FloatingComet62/phenotype-pi/references/ssr-40da-fotek.jpeg

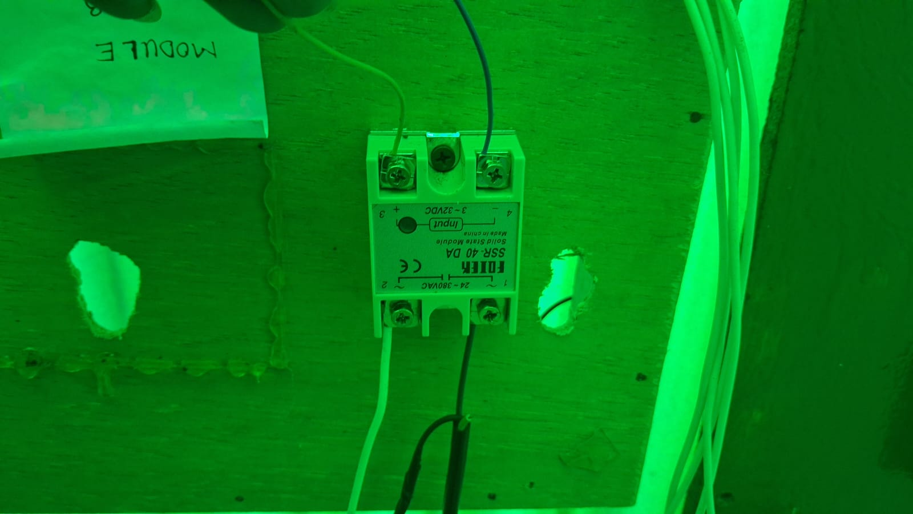
references/ssr-40da-fotek.jpeg
