FloatingComet62/phenotype-pi/(commit log)

2026-09-23 Sensor-board firmware, exhaust fan channel, reverse tunnel, and room-side docs
    Firmware (PlatformIO, src/esp32_dht): one SHT20 sketch for every ESP32
    sensor board, hostname and SSR support as build flags (esp32_dht,
    esp32_dht2/3/4 envs). Boot-time I2C probe on 18/19 then 21/22, Wi-Fi
    keepalive that restarts mDNS after a reconnect, optional two-channel SSR
    on GPIO 25/26 behind GET /relay and /status. src/esp32_relay is the
    4-channel relay sketch moved into PlatformIO. Wi-Fi credentials now come
    from git-ignored src/secrets.h (example committed); the esp8266 sketch
    reads the same header.
    Edge service: /relay-proxy gains channel "exhaust", routed to
    EXHAUST_FAN_HOST/EXHAUST_FAN_CHANNEL (the SS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
    [app.py, config.py, main.cpp]
2026-09-23 README: relay board by IP, AC 1 wiring and channel notes
2026-09-23 esp32_relay: Wi-Fi reconnect with mDNS restart, modem sleep off, outputs restored across reboots
    The deployed relay board runs the original sketch: one Wi-Fi attempt at
    boot, no reconnect, and every reboot releases the AC output, which with
    the inverted wiring switches the AC on by itself. This build keeps the
    link alive the way the sensor boards do and restores the last commanded
    outputs from NVS at boot. Needs flashing on the board.
    [main.cpp]
2026-09-23 Boards reboot themselves after 5 min without serving a request; edge keeps the relay board alive
    Three boards (relay, dht1, dht4) have twice gone into a state where they
    answer ARP but no TCP for many minutes, with no way to recover them
    remotely. Both firmwares now restart if no HTTP request has been served
    for five minutes; the Pi polls sensor boards every minute already, and
    the edge service now GETs the relay board's /status once a minute so a
    healthy relay board is never rebooted. SSR state on the sensor boards is
    persisted like the relay outputs, and modem sleep is disabled on all
    ESP32 builds.
    [app.py, main.cpp]
2026-09-23 edge: define relay_keepalive above the lifespan decorator
    It had landed between @asynccontextmanager and lifespan, so the
    decorator wrapped the keepalive and the service failed at startup.
    [app.py]
2026-09-26 edge: resolve boards by mDNS name via Avahi browse, with MAC/ARP fallback
    The router re-dealt every DHCP lease on 25 Sep and the IP-based config
    took all four zones and the AC down for a day. Hosts go back to
    .local names. Unicast .local lookups from the Pi take 5-10 s or fail,
    so the resolver reads Avahi's service-browse table instead, and for a
    board whose mDNS responder has died (dht1 and dht4 today) it finds the
    board's MAC (BOARD_MACS) in the ARP table, sweeping the subnet if the
    entry is missing. A failed request evicts the cached address.
    [app.py, config.py, dht_poller.py, resolve.py]
2026-09-28 edge resolver: identify known boards by MAC first, never by mDNS name
    Avahi reported dht1 at dht4's address while the real dht1 announced
    itself as dht1-2 after a name clash, so Zone 1 was posted with Zone 4's
    readings. Boards listed in BOARD_MACS are now located only through the
    ARP table (freshest entry wins, sweep on a miss); the browse table is
    used only for names that have no MAC. A resolved address is kept until
    a request to it fails, so the sweep is not a per-cycle cost.
    [resolve.py]
2026-09-28 esp32_relay: Wi-Fi escalation with backed-off restarts, 13 dBm, held outputs, diagnostics
    Applies the four Wi-Fi points to the board that switches the AC and the
    four relays: modem sleep off, transmit power 13 dBm behind a build flag,
    DHCP only, and recovery that escalates from reconnect to a Wi-Fi driver
    restart at 30 s to a chip restart at 60 s (or 5 min without a served
    request). Restarts back off up to 16x while nothing is served, outputs
    are restored before Wi-Fi starts and latched across a planned restart,
    and /status reports rssi, uptime and restart count. Hostname is now
    'relay', matching the deployed board. Compiles; not yet run on hardware.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
2026-09-28 esp32_relay: valve relays always start closed; only the AC is restored at boot
    Channels 1-4 drive water valves. Returning a valve to 'open' after an
    unattended restart is the unsafe direction, so they start closed.
2026-09-28 esp32_relay: keep /relay's missing-parameter error identical to the original sketch
    [main.cpp]
2026-09-28 README: relay board flashed with the esp32_relay build
2026-09-28 Valve channels with a master valve, a second AC channel, and the dht4 sensor+AC sketch
    Edge: /relay-proxy gains valve1..valve3, which drive relay 1-3 on the
    relay board and take the master valve (VALVE_MASTER_CHANNEL, relay 4)
    with them: master opens first, and closes only when the last branch
    closes. Identified on site on 28 Sep by opening pairs. Channel "ac2"
    drives the /ac output on AC2_HOST (dht4), active high. Tested against a
    fake board in tests/test_relay_proxy.py.
    Firmware: src/esp32_dht_ac is the owner's dht4 sketch (SHT20 on 21/22,
    AC on GPIO 23, Wi-Fi restart after 45 s down, sleep off, 13 dBm), kept
    as delivered with credentials moved to secrets.h. The esp32_dht4 env
    builds it.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
2026-09-28 README: valve and AC 2 channels, dht4 sketch
2026-09-28 esp32_stack: HTTP bridge between the Pi and a stack's Arduino over UART
    The Arduino drives a stack's three LED strips and pump and reads pH and
    pump current, speaking a comma-separated line protocol at 115200 baud.
    This ESP32 sketch exposes it on the Wi-Fi: /reading, /status, /led and
    /pump. Inputs are range-checked, commands are spaced 150 ms apart
    because the Arduino is deaf while FastLED.show() runs, and telemetry
    lines that do not parse are counted and dropped. Same Wi-Fi recovery as
    the relay board. Builds; not yet run against the Arduino.
2026-09-28 esp32_stack: hardware watchdog, commanded state in flash, automatic re-send
    The Arduino never acknowledges a command and forgets its outputs when it
    resets, so the bridge now keeps what the Pi last asked for (pump speed
    and up to four LED segments per strip) in flash and sends it again when
    telemetry resumes after a gap and once a minute regardless, one command
    per 150 ms so requests are still served meanwhile. A new LED segment
    replaces the one with the same range and swallows any it covers. The
    task watchdog restarts the chip if the loop stops for 30 s. Nothing
    switches the pump or LEDs off by itself. Parser and segment store are
    checked at boot and were run on the host; not yet run on har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
    [main.cpp]
2026-09-28 esp32_stack: log and report why the access point refused or dropped the board
    Status 4 says only that connecting failed. The disconnect reason says
    why (wrong password, network not found, access point full), is printed
    on serial and returned as wifi_reason in /status.
    [main.cpp]
2026-09-28 Edge: stack LED route with the measured row map; keepalive for stack bridges
    POST /stack-led takes a stack, shelf, row and colour and sends the row's
    strip segment to that stack's bridge. The row map is the one measured on
    site on 28 Sep (phenotype_edge/stacks.py). STACK_HOSTS names the bridges
    in stack order; KEEPALIVE_HOSTS keeps boards that nothing polls from
    restarting themselves.
2026-09-28 README: row LED map, stack LED path, router device limit
2026-09-28 Edge: pump channel and tank pH for stack bridges
    /relay-proxy channel "pumpN" sets stack N's pump to PUMP_ON_SPEED (128,
    the Arduino sketch's own default) or 0. stack_poller reads each bridge's
    /reading every poll interval and posts a fresh, plausible pH to that
    stack's pH sensor on the backend, found by stack order through /farm and
    /v2/sensors.
2026-09-28 README: pump and pH paths for stack bridges
2026-09-28 docs: curl commands for every board, the Pi's edge service, and the website API
2026-10-13 Edge: one stack-bridge command at a time, spaced, newest per row wins
    The stack's Arduino mis-applies commands sent in bursts but handles
    single ones. STACK_COMMAND_GAP_S (default 1 s) spaces them; a queued
    colour for a row is dropped when a newer one for the same row arrives.
2026-10-13 Row map: upper shelf rows 1-3 on pin 11 (path 2), both row 4s on pin 12 (path 1)
2026-10-13 esp32_stack: never re-send; one press is one line to the Arduino
    The bridge replayed every stored segment at boot, every 60 s and after a
    telemetry gap, re-lighting rows nobody pressed (and stale ones). Replay
    removed; the stored state is kept only for /status. /status gains
    reset_reason to tell brownouts from watchdog restarts.
2026-10-13 Edge: fold row dimming into the colour, always brightness 255
    The stack Arduino applies brightness to the whole strip, so one row sent
    with brightness 0 blacked out the shelf and the next row on relit every
    row. Off is now black for that row only.
2026-10-13 Row map: row 4s swapped between shelves; shelf 2 row 4 is LEDs 19-96
2026-10-14 resolve: drop a remembered board address once its MAC changes
    Leases move between boards; dht4's old address went to dht2, which
    answered AC 2 commands with 404 instead of failing, so the stale address
    was never forgotten.
2026-10-14 Edge: pump channels take a speed from the backend (falls back to PUMP_ON_SPEED)
2026-10-30 esp32_dht: hardware watchdog, I2C bus recovery, heap guard, health in /reading
    - 30 s task watchdog: a hang inside loop() (Wi-Fi driver, I2C) resets the chip.
    - 5 failed reads in a row: SCL pulses free a stuck SDA, then both pin pairs
    are probed again (also finds a sensor plugged in after boot).
    - Free heap under 20 KB: clean restart instead of a starved network stack.
    - /reading reports free/min heap, RSSI, uptime, reset reason, I2C recoveries;
    the 503 says which pins were tried.
2026-10-30 esp32_dht: join any known network (WiFiMulti); optional WIFI_SSID_FARM in secrets.h
    Lets the boards move from the old router to the new one without a reflash
    in between: whichever known network is in range is joined.
2026-10-30 esp32_dht: join the farm network (Poly House) only
2026-10-30 dht4 sketch: Poly House Wi-Fi, 30 s hardware watchdog, reboot after 5 min unserved
    Owner's sketch otherwise unchanged. Guards the connected-but-frozen case
    its disconnect-based reconnect never sees.
2026-10-30 esp32_stack: Poly House Wi-Fi
